marc-bojarzin/fenderswitch/hardware/fenderswitch/fenderswitch.kicad_sch

## KiCad design hardware/fenderswitch/fenderswitch.kicad_sch (2026-11-03)

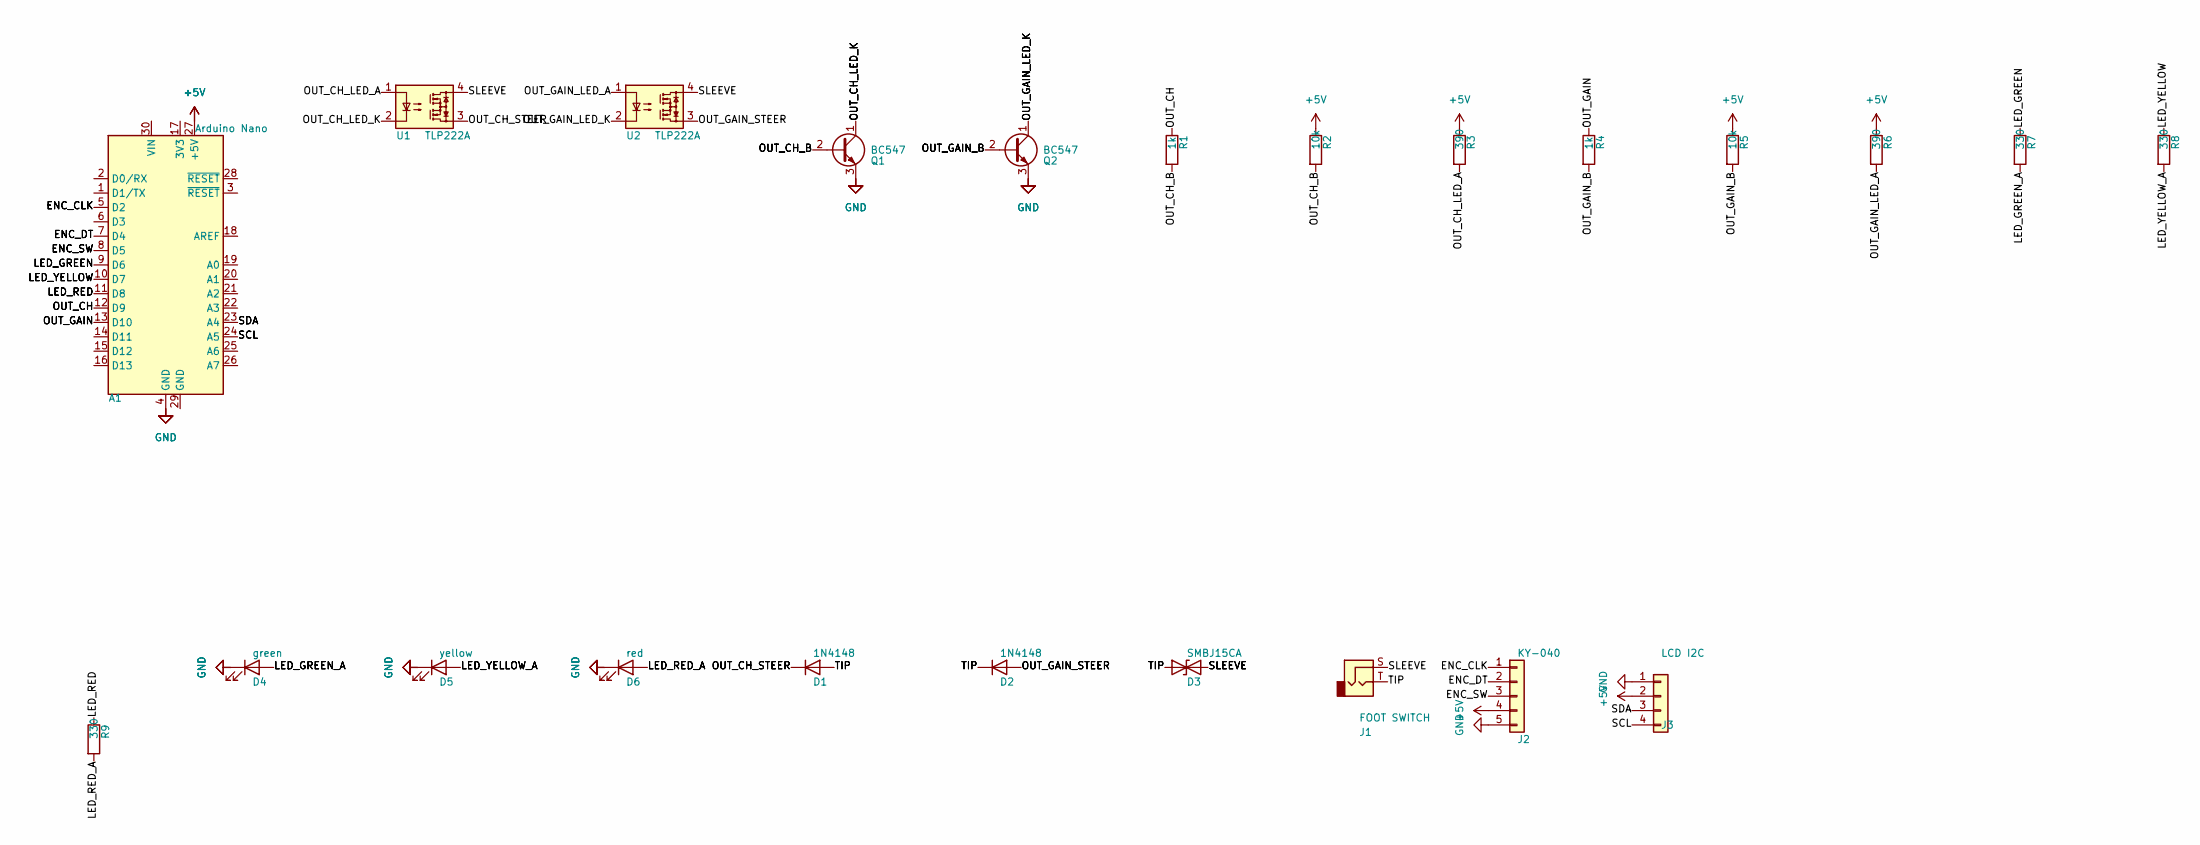
[picture p1: schematic fenderswitch.kicad_sch]

Parts:
A1: Arduino Nano
D1, D2: 1N4148
D3: SMBJ15CA
D4: green
D5: yellow
D6: red
J1: FOOT SWITCH
J2: KY-040
J3: LCD I2C
Q1, Q2: BC547
R1, R4: 1k
R2, R5: 10k
R3, R6: 390
R7, R8, R9: 330
U1, U2: TLP222A

Connections:
+5V: A1.27 (+5V), J2.4, J3.2, R2.1, R3.1, R5.1, R6.1
ENC_CLK: A1.5 (D2), J2.1
ENC_DT: A1.7 (D4), J2.2
ENC_SW: A1.8 (D5), J2.3
GND: A1.4 (GND), D4.1 (K), D5.1 (K), D6.1 (K), J2.5, J3.1, Q1.3 (E), Q2.3 (E)
LED_GREEN: A1.9 (D6), R7.1
LED_GREEN_A: D4.2 (A), R7.2
LED_RED: A1.11 (D8), R9.1
LED_RED_A: D6.2 (A), R9.2
LED_YELLOW: A1.10 (D7), R8.1
LED_YELLOW_A: D5.2 (A), R8.2
OUT_CH: A1.12 (D9), R1.1
OUT_CH_B: Q1.2 (B), R1.2, R2.2
OUT_CH_LED_A: R3.2, U1.1
OUT_CH_LED_K: Q1.1 (C), U1.2
OUT_CH_STEER: D1.1 (K), U1.3
OUT_GAIN: A1.13 (D10), R4.1
OUT_GAIN_B: Q2.2 (B), R4.2, R5.2
OUT_GAIN_LED_A: R6.2, U2.1
OUT_GAIN_LED_K: Q2.1 (C), U2.2
OUT_GAIN_STEER: D2.2 (A), U2.3
SCL: A1.24 (A5), J3.4
SDA: A1.23 (A4), J3.3
SLEEVE: D3.2 (A2), J1.S, U1.4, U2.4
TIP: D1.2 (A), D2.1 (K), D3.1 (A1), J1.T
