marc-bojarzin/fenderswitch/(commit log)

2026-11-03 Restructure firmware into cooperative tasks, add presets and channel buttons
    - Task.hpp: protothread-style cooperative tasks and a round-robin
    scheduler, no delay() anywhere
    - RotaryEncoder/EncoderTask: browse 128 presets, LCD follows at once,
    the amp switches after the encoder rests 300 ms; Enter toggles a
    placeholder menu mode
    - Preset/PresetLoader: presets in EEPROM, loaded into RAM at boot,
    working buffer with dirty tracking
    - OpticalRelay: make-before-break switching of the two photorelays
    - ChannelTask: channel buttons switch immediately, hold 2 s or Store
    saves a dirty preset
    - Led: PWM swell for a dirty preset; LcdBuffer: shadow buffer for the
    16x2 I2C LCD; StatsTask: loo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
    [fenderswitch.kicad_sch]
2026-11-05 Drive photorelays directly, decode encoder by quadrature
    - Relays: drop the NPN driver stage; D7/D8 drive the TLP222A input LEDs
    through 390 ohm. HIGH = relay ON. Both relays are open (More Drive)
    during reset and boot; documented in the README.
    - Encoder: full quadrature decoding on the port D pin-change interrupt
    (PCINT2) for both CLK and DT.
    - Store on a clean preset winks the channel LED as acknowledgement.
    - README: wiring table matches main.cpp (relays D7/D8, LEDs D9-D11 on
    PWM pins), new section on checking the relay stages.
    - docs/schematics.py: new relay input schematic, encoder labels updated.
    [EncoderTask.cpp, EncoderTask.hpp, Led.cpp, Led.hpp, OpticalRelay.cpp, OpticalRelay.hpp, RotaryEncoder.cpp, RotaryEncoder.hpp]
2026-11-05 Read MIDI IN: Program Change recalls its preset
    - MidiParser: byte-by-byte MIDI 1.0 parser with running status,
    real-time bytes inside messages, SysEx and stray data bytes.
    - MidiTask: drains the UART each pass, filters by MIDI channel or
    OMNI (build flags MIDI_CHANNEL / MIDI_OMNI until the menu exists)
    and selects the program right away.
    - EncoderTask::select(): selects a program without the browse delay.
    DIN and USB share D0/RX, so the same code serves both inputs.
2026-11-05 Add USB MIDI bridge and web footboard
    - tools/usb_midi_bridge.py: virtual ALSA MIDI port forwarded to the
    Nano at 31250 baud (mido, python-rtmidi, pyserial); --no-monitor
    leaves the firmware output to a separate serial monitor.
    - tools/footboard: Node.js web footboard; footswitch buttons send
    Program Change over USB serial, the page mirrors the device's
    display and channel LEDs from the firmware output.
    - README: MIDI section (build flags, both inputs, bridge, footboard).
2026-11-05 Split footboard and device monitor, add start script
    - Footboard: plain MIDI footboard that only sends Program Change and
    knows nothing about the presets. 3-digit 7-segment display (SVG)
    with the program last sent, status LED per switch, brushed
    aluminium enclosure.
    - Device monitor: separate page with the fenderswitch's LCD, channel
    LEDs and a log of MIDI bytes sent and the firmware's serial output.
    - Server: separate APIs, /api/midi/... for the footboard and
    /api/monitor/events for the monitor. The start page shows both
    side by side; each also works on its own.
    - start.sh: installs dependencies on first run, refuses to start while
    another program holds the serial port; option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
2026-11-08 Replace the LCD with a TM1637 7-segment display
    The 4-digit display shows the program number, or "----" in menu mode.
    SegmentDisplay keeps a shadow copy and only talks to the chip when
    something changed. The device monitor mirrors the new display.
    [ChannelTask.hpp, EncoderTask.cpp, EncoderTask.hpp, MidiTask.hpp, SegmentDisplay.cpp, SegmentDisplay.hpp, main.cpp]
2026-11-08 Add MIDI menu, run EncoderTask as a state machine
    The encoder button opens a menu with ALL (OMNI), CH:01-CH:16 and ESC;
    Enter or Store confirms. The setting lives in EEPROM byte 128
    (MidiSettings), MIDI_OMNI / MIDI_CHANNEL are now only the fresh-EEPROM
    default. EncoderTask::run() dispatches to one handler per state (live,
    browsing, menu). The device monitor mirrors the menu entries.
2026-11-08 Settings menu with submenus, add display brightness
    The encoder button now opens a top menu (Chan / dISP / ESC). Chan holds
    the MIDI channel entries as before; dISP sets the 7-segment brightness
    (br:01-br:08) with a live preview. ESC in a submenu goes back up without
    saving. MidiSettings becomes Settings, which also keeps the brightness
    in EEPROM byte 129. The device monitor shows the new entries and dims
    its display along with the device.
2026-11-09 Show the channel as a staircase symbol on the display
    Programs only use the right three digits, so the leftmost one now shows
    the working buffer's channel as bars: one for Clean, two for Drive,
    three for More Drive. SegmentDisplay::showNumber() takes the segments
    of that leading digit. The device monitor draws the same symbol.
2026-11-09 Halve the browse settle time to 150 ms
    The amp follows the encoder sooner once it rests.
2026-11-09 Debounce buttons on the leading edge, set up pins in begin()
    A press now counts on the first LOW reading instead of after 30 ms of
    stable level; the pin is ignored for BUTTON_DEBOUNCE_MS after each
    change while the contact bounces. Button and RotaryEncoder get a
    begin() called from setup() instead of touching the pins in their
    constructors, and a button held at power-up no longer counts as a
    press. BUTTON_DEBOUNCE_MS can be overridden like the other timings.
    [Button.cpp, Button.hpp, RotaryEncoder.cpp, RotaryEncoder.hpp, main.cpp]
2026-11-09 Display: "donE" after storing, MIDI colon flash, dim when idle
    The display shows "donE" for STORE_DONE_MS after a preset was stored,
    flashes the colon for MIDI_COLON_MS on every accepted Program Change,
    and dims to the lowest brightness after IDLE_DIM_MS without input; the
    next input, MIDI included, brings the stored brightness back. The
    device monitor follows all three from the serial log.
2026-11-09 Füge eine Leerzeile zwischen den Variablen in der Led-Klasse hinzu
